SamuelSylvester/DE10-Lite-Peripheral-Board/README.md

## DSD SHIELD

Folder to contain the DE10-Lite shield for ECE 4110/5110 development

Include all files, libraries, and documents.
