SamuelSylvester/DE10-Lite-Peripheral-Board/FPGA-Shield-Rev0/ArduinoUnoR3-SSW/SSW-110-01-XXX-S.step

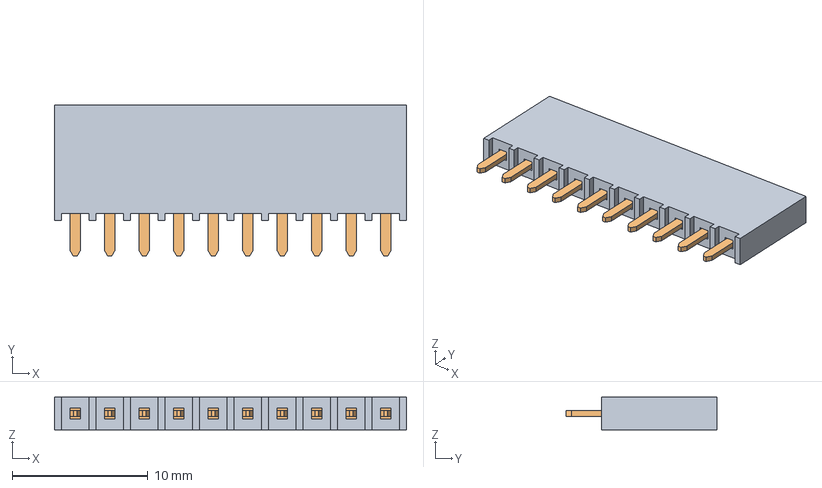
[picture p1: CAD file, 2024-01-12]
FPGA-Shield-Rev0/ArduinoUnoR3-SSW/SSW-110-01-XXX-S.step
25.9 x 11.2 x 2.41 mm
_T1SSW-110-01-F-S
_P2SSW-110-01-F-S
