SamuelSylvester/DE10-Lite-Peripheral-Board/FPGA-Shield-Rev0/ArduinoUnoR3-SSW/SSW-106-01-X-S.step

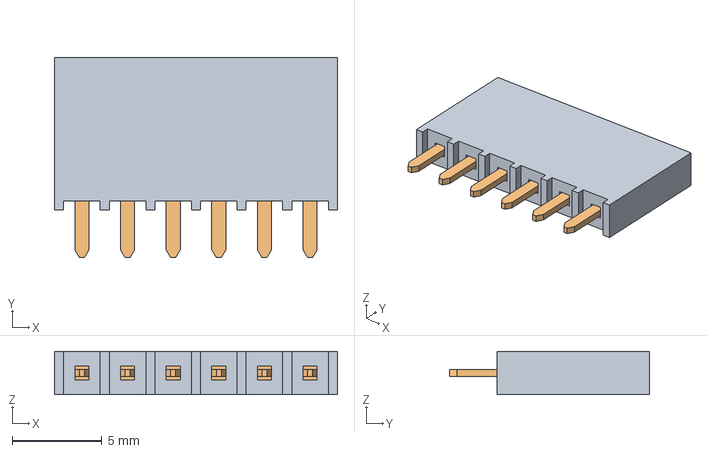
[picture p2: CAD file, 2024-01-12]
FPGA-Shield-Rev0/ArduinoUnoR3-SSW/SSW-106-01-X-S.step
15.7 x 11.2 x 2.41 mm
_T1SSW-106-01-F-S
_P2SSW-106-01-F-S
