SamuelSylvester/DE10-Lite-Peripheral-Board/FPGA-Shield-Rev0/ArduinoUnoR3-SSW/SSW-108-XX-X-S.step

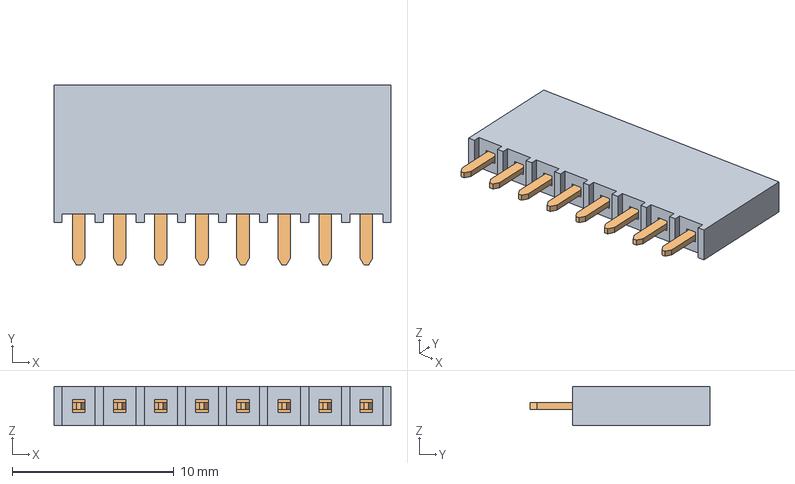
[picture p3: CAD file, 2024-01-12]
FPGA-Shield-Rev0/ArduinoUnoR3-SSW/SSW-108-XX-X-S.step
20.8 x 11.2 x 2.41 mm
_T1SSW-108-01-F-S
_P2SSW-108-01-F-S
