SamuelSylvester/DE10-Lite-Peripheral-Board/FPGA-Shield-Schematic.pdf

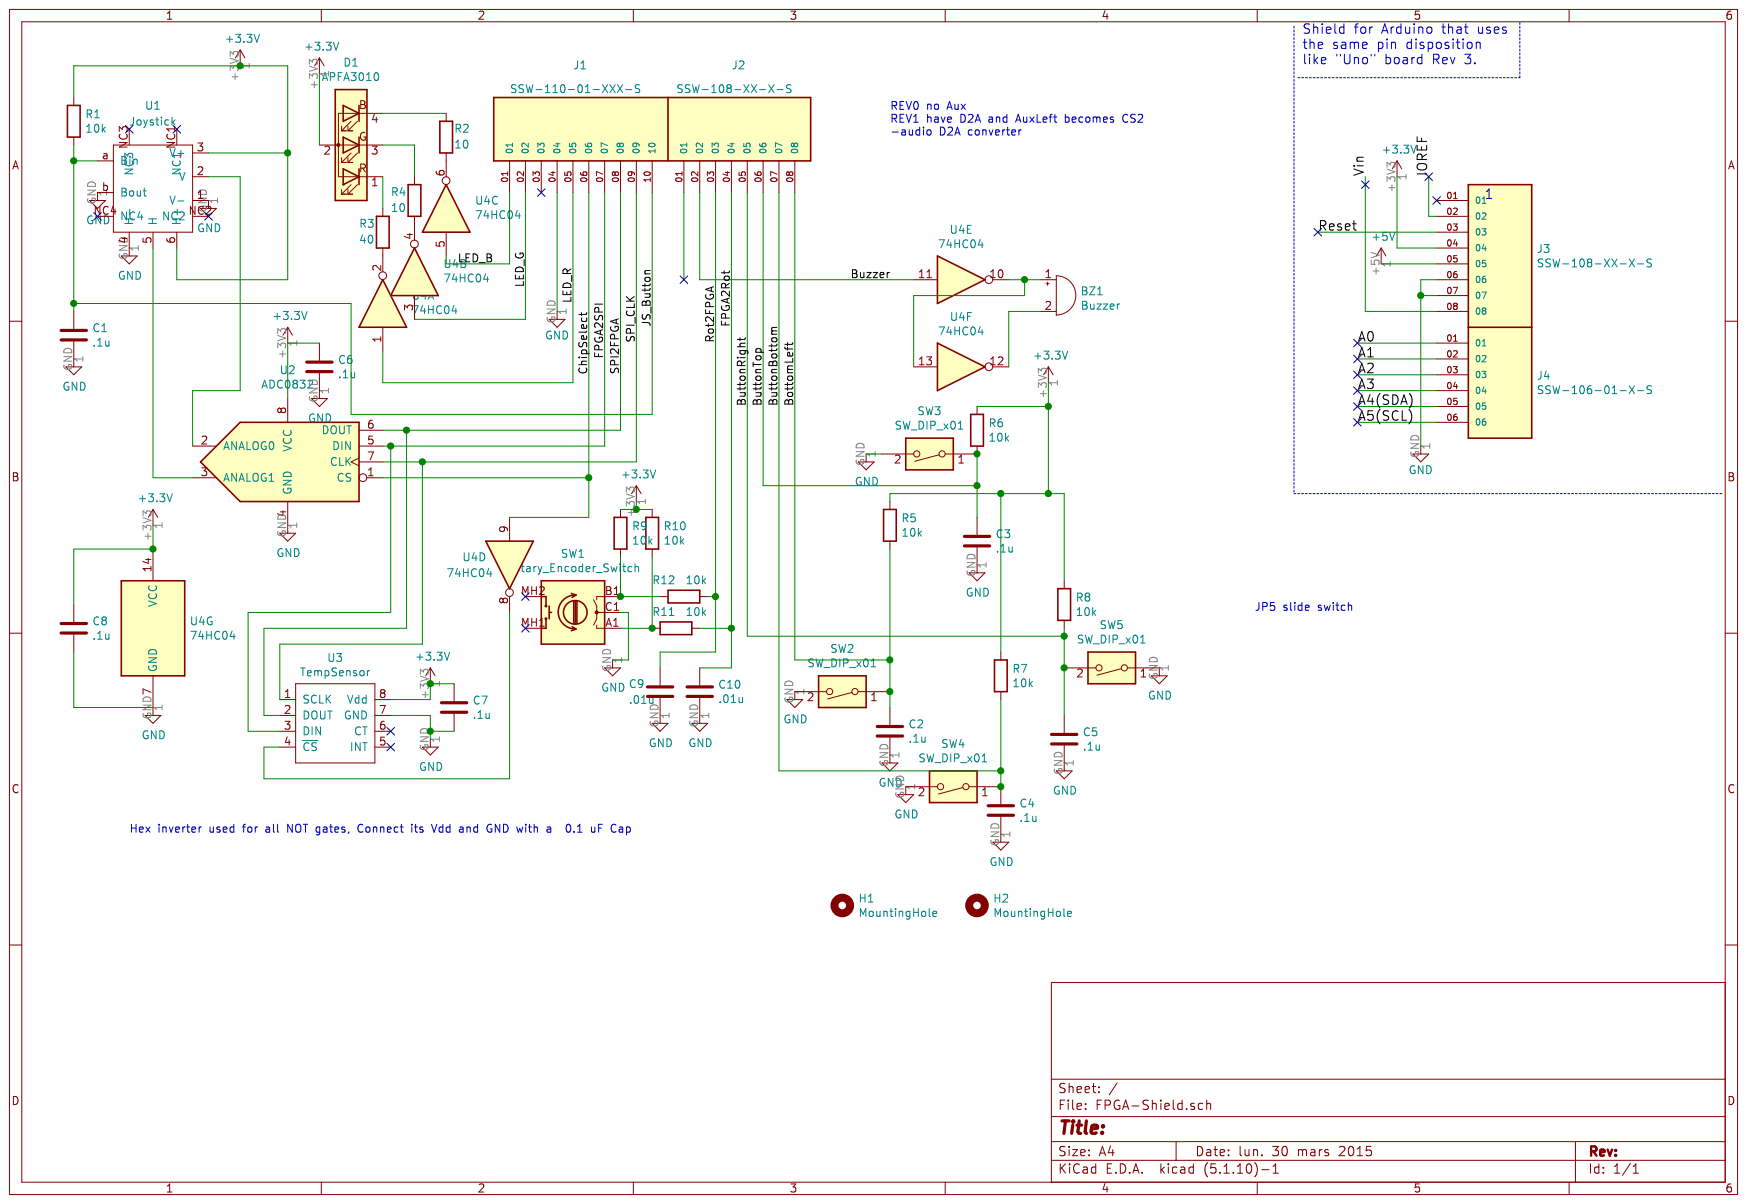
[picture p4: page 1]
