SamuelSylvester/DE10-Lite-Peripheral-Board/FPGA-Shield-Layout.pdf

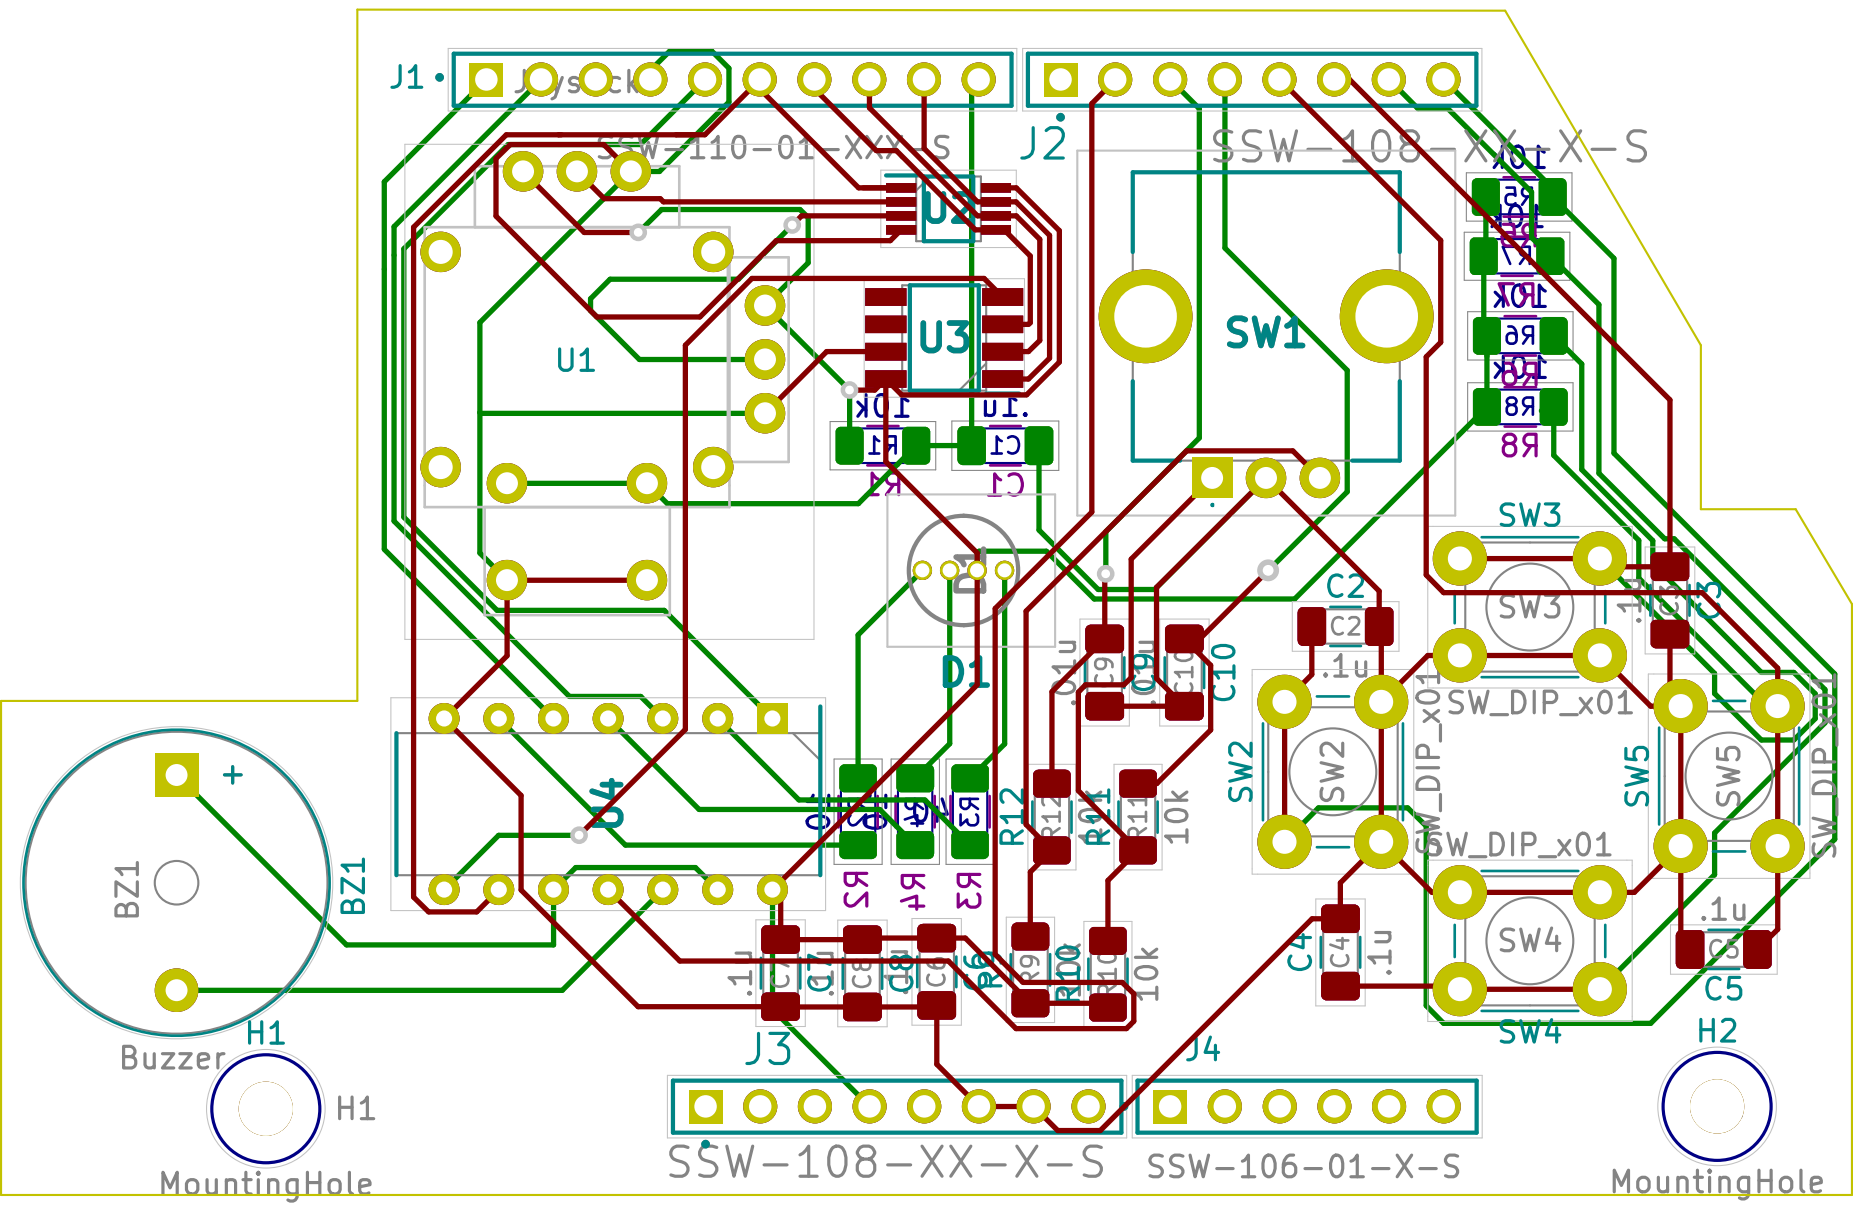
[picture p5: page 1]
