SamuelSylvester/DE10-Lite-Peripheral-Board/FPGA-Shield-Rev0/FPGA-Shield.pdf

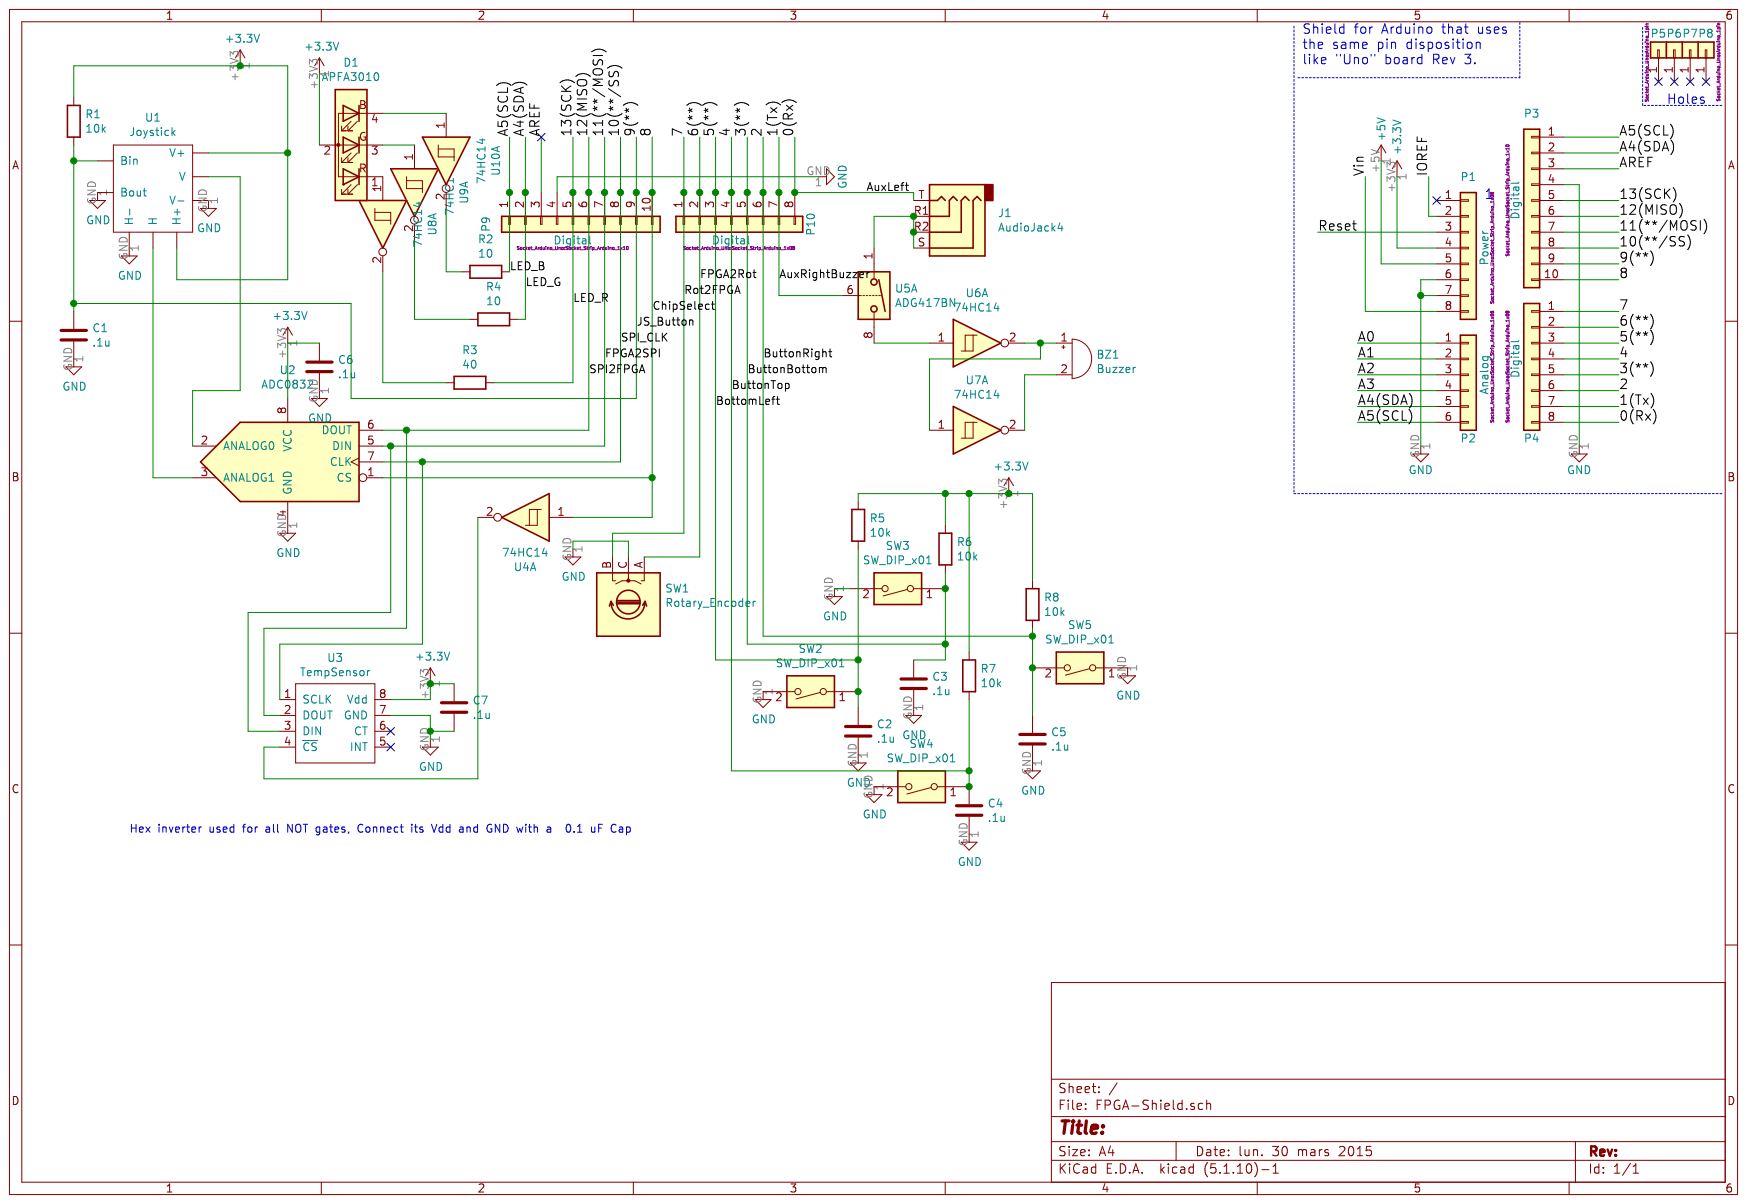
[picture p6: page 1]
