SamuelSylvester/DE10-Lite-Peripheral-Board/FPGA-Shield-Rev0/FPGA-Shield.kicad_pcb

## KiCad design FPGA-Shield-Rev0/FPGA-Shield.kicad_pcb (2024-01-12)

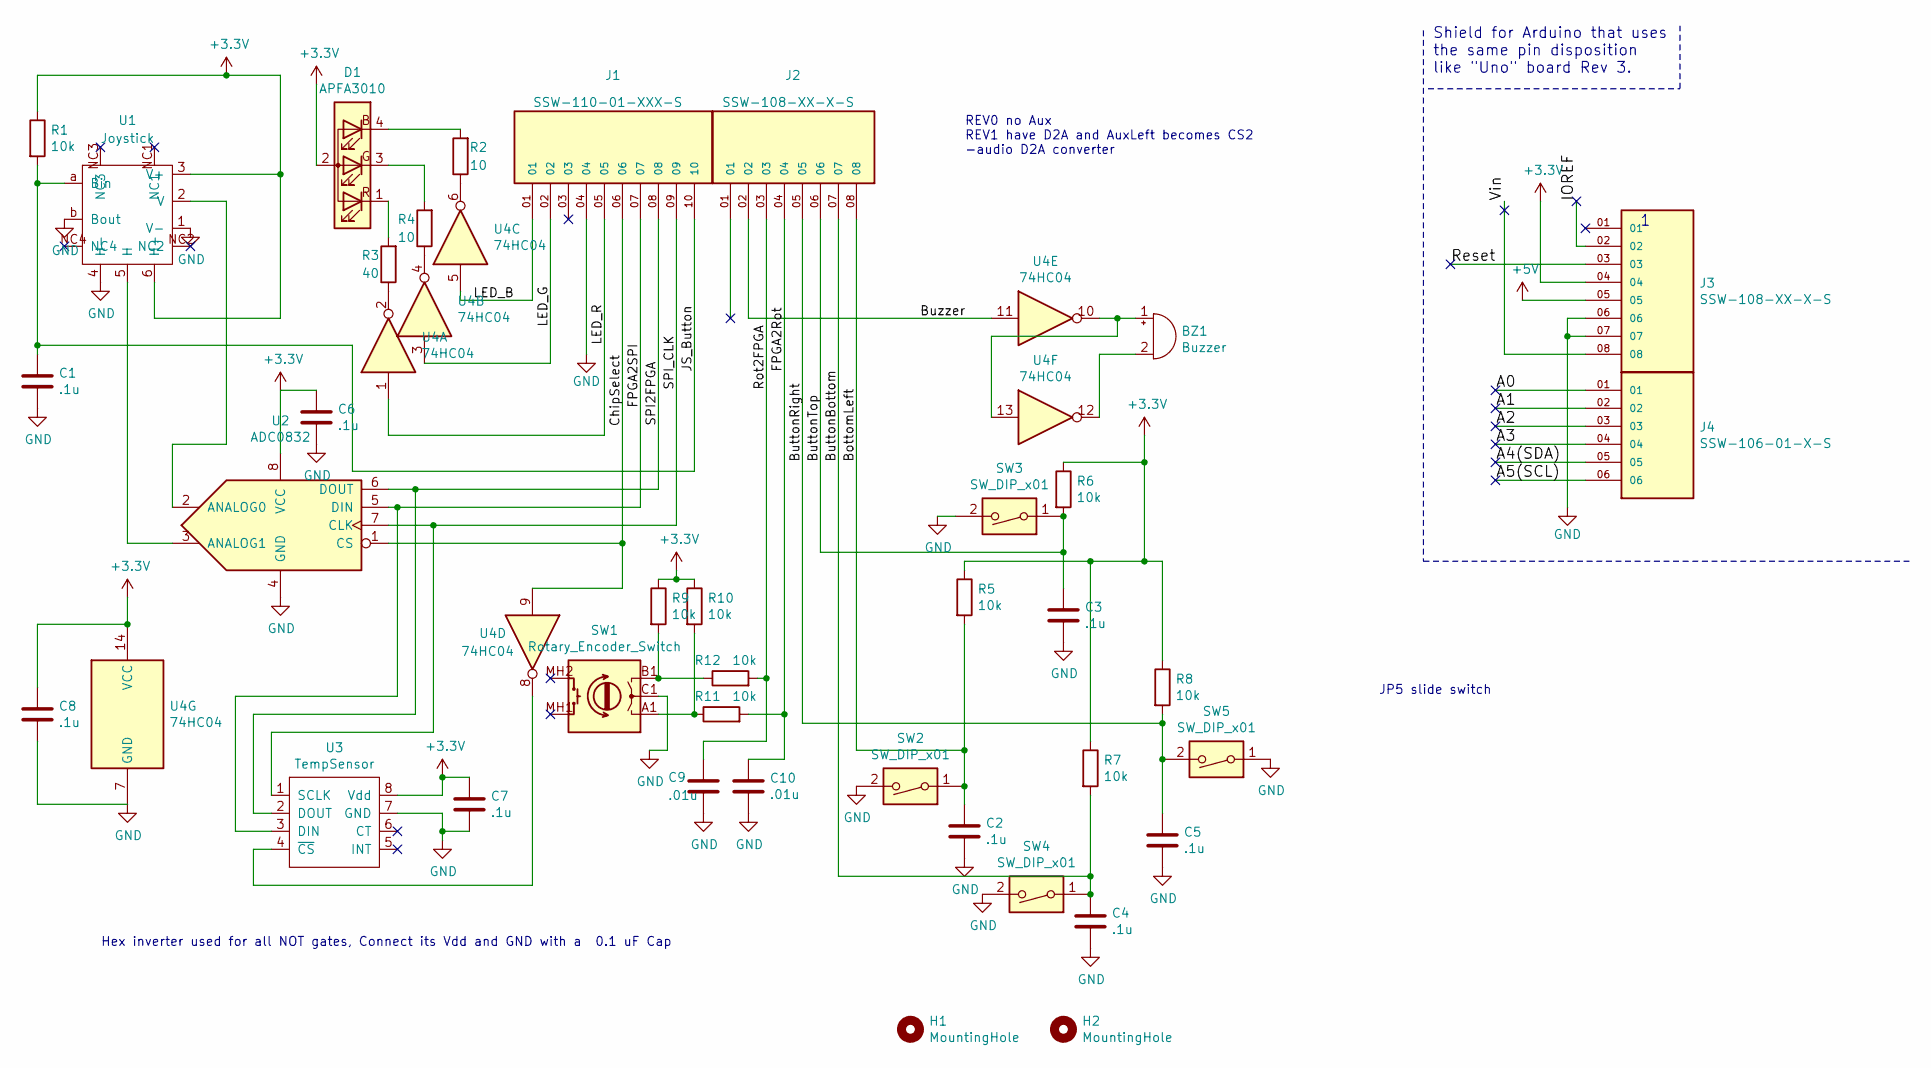
[picture p7: schematic FPGA-Shield.sch]

Parts:
BZ1: Buzzer; Buzzer_D14mm_H7mm_P10mm
C1, C2, C3, C4, C5, C6, C7, C8: .1u; C_1206_3216Metric_Pad1.33x1.80mm_HandSolder
C9, C10: .01u; C_1206_3216Metric_Pad1.33x1.80mm_HandSolder
D1: APFA3010; RGBLED-5218559F
H1, H2: MountingHole; MountingHole_2.5mm
J1: SSW-110-01-XXX-S; SAMTEC_SSW-110-01-XXX-S; PARTREV A
J2, J3: SSW-108-XX-X-S; SAMTEC_SSW-108-XX-X-S; PARTREV A
J4: SSW-106-01-X-S; SAMTEC_SSW-106-01-X-S; PARTREV A
R1, R5, R6, R7, R8, R9, R10, R11, R12: 10k; R_1206_3216Metric_Pad1.30x1.75mm_HandSolder
R2, R4: 10; R_1206_3216Metric_Pad1.30x1.75mm_HandSolder
R3: 40; R_1206_3216Metric_Pad1.30x1.75mm_HandSolder
SW1: Rotary_Encoder_Switch; RotaryEncoder-PEC12R4020FN0024
SW2, SW3, SW4, SW5: SW_DIP_x01; SW_PUSH_6mm_LargeHoles
U1: Joystick
U2: ADC0832; ADC-SOP65P490X110-8N
U3: TempSensor; TempSensor-SOIC127P600X175-8N
U4: 74HC04; HexInv-DIP794W53P254L1930H508Q14N

Connections:
+3V3: C6.1, C7.1, C8.1, D1.2 (A), J3.04, R1.1, R5.1, R6.1, R7.1, R8.1, R9.1, R10.1, U1.3 (V+), U1.6 (H+), U2.8 (VCC), U3.8 (Vdd), U4.14 (VCC)
+5V: J3.05
/A0: J4.01
/A1: J4.02
/A2: J4.03
/A3: J4.04
/A4(SDA): J4.05
/A5(SCL): J4.06
/BottomLeft: C2.1, J2.08, R5.2, SW2.1
/ButtonBottom: C4.1, J2.07, R7.2, SW4.1
/ButtonRight: C5.1, J2.05, R8.2, SW5.2
/ButtonTop: C3.1, J2.06, R6.2, SW3.1
/Buzzer: J2.02, U4.11
/ChipSelect: J1.06, U2.1 (CS), U4.9
/FPGA2Rot: C10.1, J2.04, R11.2
/FPGA2SPI: J1.07, U2.5 (DIN), U3.3 (DIN)
/IOREF: J3.02
/JS_Button: C1.1, J1.10, R1.2, U1.a (Bin)
/LED_B: J1.01, U4.5
/LED_G: J1.02, U4.3
/LED_R: J1.05, U4.1
/Reset: J3.03
/Rot2FPGA: C9.1, J2.03, R12.2
/SPI2FPGA: J1.08, U2.6 (DOUT), U3.2 (DOUT)
/SPI_CLK: J1.09, U2.7 (CLK), U3.1 (SCLK)
/Vin: J3.08
GND: C1.2, C2.2, C3.2, C4.2, C5.2, C6.2, C7.2, C8.2, C9.2, C10.2, J1.04, J3.06, J3.07, SW1.C1, SW2.2, SW3.2, SW4.2, SW5.1, U1.1 (V-), U1.4 (H-), U1.b (Bout), U2.4 (GND), U3.7 (GND), U4.7 (GND)
unnamed: BZ1.1 (-), U4.10, U4.13
unnamed: BZ1.2 (+), U4.12
unnamed: D1.1 (R), R3.2
unnamed: D1.3 (G), R4.2
unnamed: D1.4 (B), R2.2
unnamed: R2.1, U4.6
unnamed: R3.1, U4.2
unnamed: R4.1, U4.4
unnamed: R10.2, R11.1, SW1.A1
unnamed: R9.2, R12.1, SW1.B1
unnamed: U1.2 (V), U2.2 (ANALOG0)
unnamed: U1.5 (H), U2.3 (ANALOG1)
unnamed: U3.4 (~CS), U4.8

Notes on the sheet:
Shield for Arduino that uses the same pin disposition like "Uno" board Rev 3.
Hex inverter used for all NOT gates, Connect its Vdd and GND with a 0.1 uF Cap
JP5 slide switch
REV0 no Aux REV1 have D2A and AuxLeft becomes CS2 -audio D2A converter

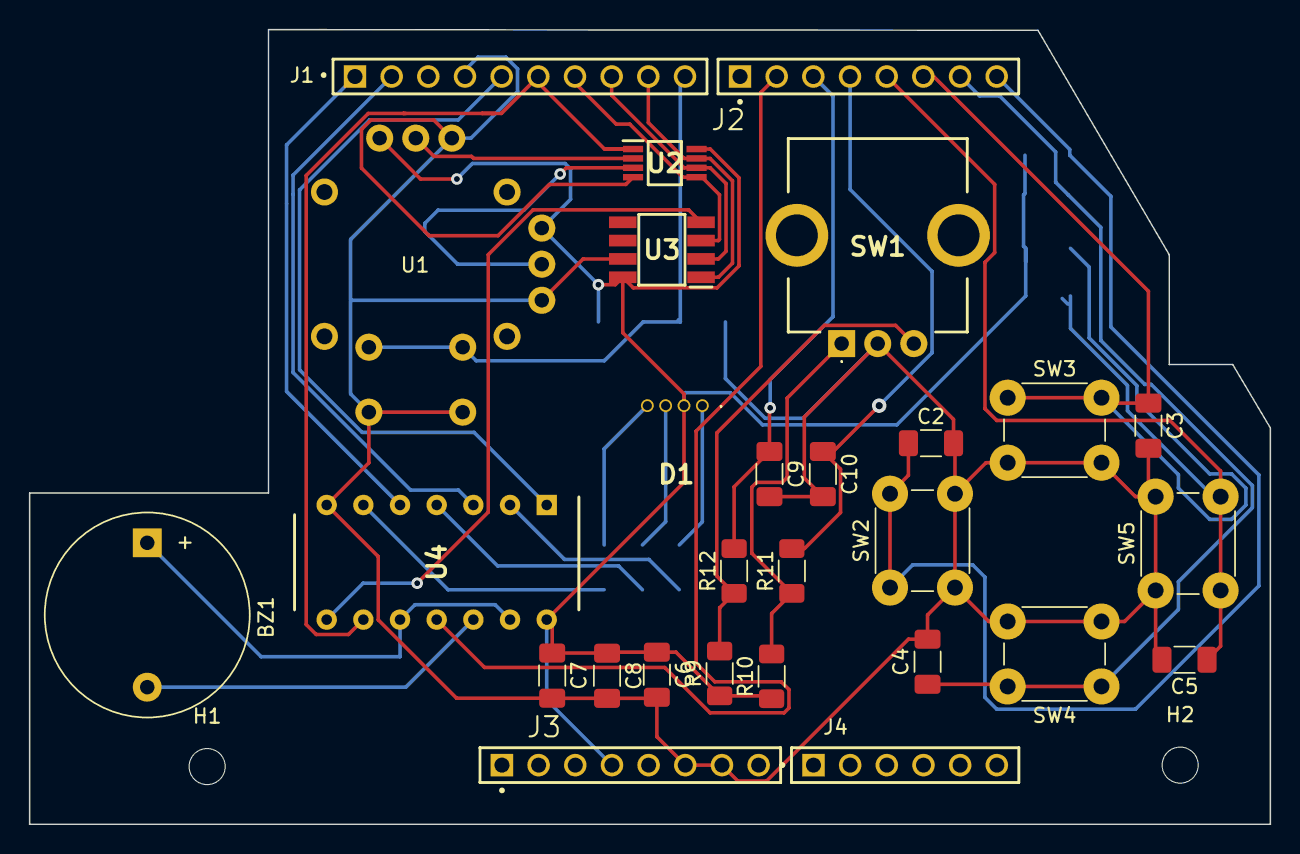
[picture p8: board FPGA-Shield.kicad_pcb from above]

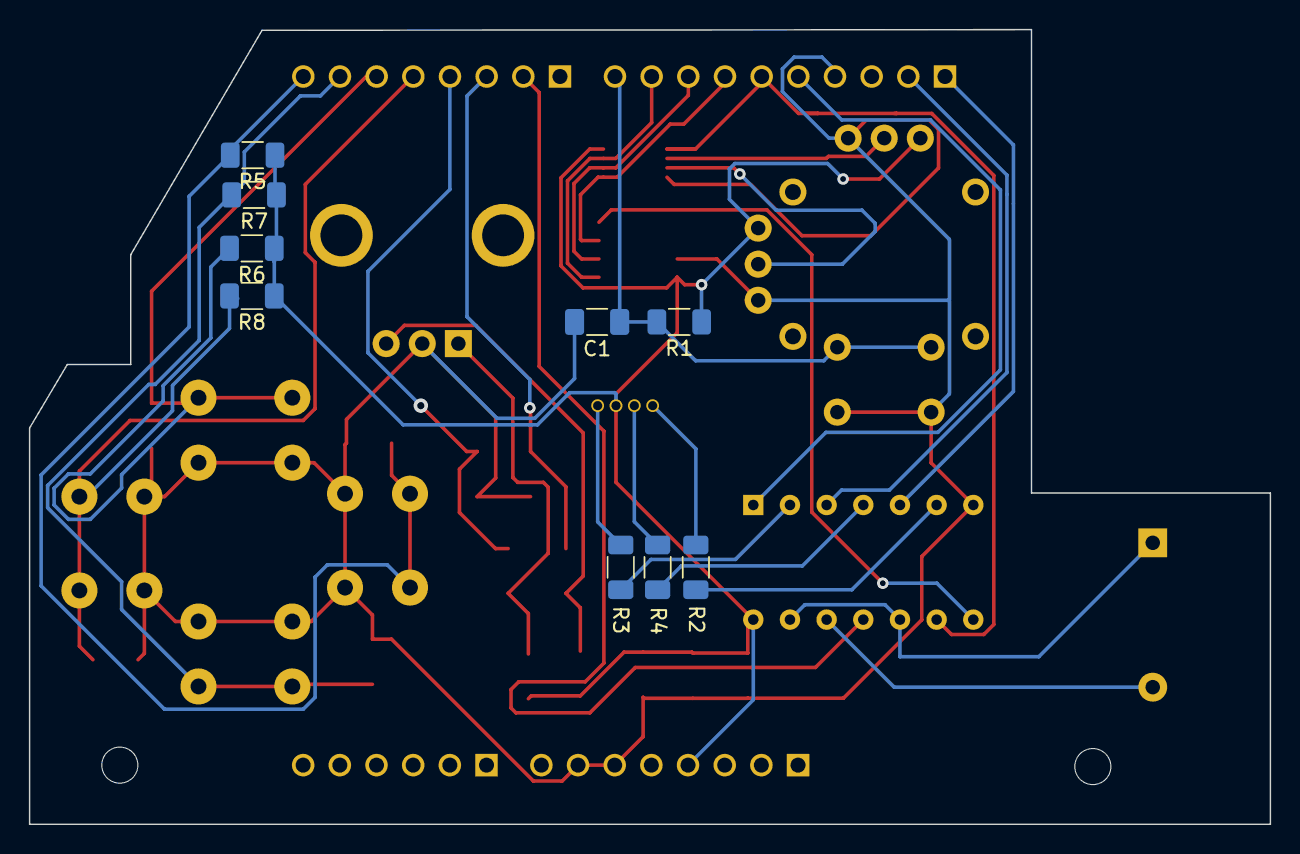
[picture p9: board FPGA-Shield.kicad_pcb from below]

Board: 2 copper layers, 85.9 x 55.0 mm, 39 parts (9 on the bottom side), 30 nets.
