SamuelSylvester/DE10-Lite-Peripheral-Board/(notices)

Notices in the files:
FPGA-Shield-Rev0/ArduinoUnoR3-SSW/SSW-108-XX-X-S.step:
FILE_NAME( 'e:/temp/worker_56/temp/exporttempdir_7516_2134_uFXZc/format_0/SSW-108-01-F-S.stp', '2021-12-02T03:25:49', ( 'License CC BY-ND 4.0' ), ( 'CADENAS' ), ' ', 'PARTsolutions', ' ' );
FPGA-Shield-Rev0/ArduinoUnoR3-SSW/SSW-106-01-X-S.step:
FILE_NAME( 'e:/temp/worker_59/temp/exporttempdir_7980_453_DGqva/format_0/SSW-106-01-F-S.stp', '2021-12-02T03:26:01', ( 'License CC BY-ND 4.0' ), ( 'CADENAS' ), ' ', 'PARTsolutions', ' ' );
FPGA-Shield-Rev0/ArduinoUnoR3-SSW/SSW-110-01-XXX-S.step:
FILE_NAME( 'e:/temp/worker_62/temp/exporttempdir_6596_436_bYRhL/format_0/SSW-110-01-F-S.stp', '2021-12-02T03:26:12', ( 'License CC BY-ND 4.0' ), ( 'CADENAS' ), ' ', 'PARTsolutions', ' ' );
